Shayshez/Dazzle/README.md

# Dazzle
## CC-BY-SA 4.0
Rotatable Dual VC-Polarizer and VCA, Based on MI "Blinds".

## ROTATABLE = Modules for 3u / 1u
Dazzle comes with 2 panels: 1u/20hp and 3u/6hp
