Shayshez/Dazzle/Dazzles_v1_BOM.xlsx

Qty | Value | Device | Package | Parts | Description
1 | DNP | Resistor, 1% | R0603 | R35 | RESISTOR, American symbol
2 | 402R | Resistor, 1% | R0603 | R5, R6 | RESISTOR, American symbol
4 | 510R | Resistor, 1% | R0603 | R26, R31, R36, R43 | RESISTOR, American symbol
6 | 1.2k | Resistor, 1% | R0603 | R37, R38, R56, R57, R58, R59 | RESISTOR, American symbol
2 | 3.90k | Resistor, 0.1%, thin film | R0603 | R14, R15 | RESISTOR, American symbol
6 | 4.30k | Resistor, 0.1%, thin film | R0603 | R11, R16, R17, R18, R29, R32 | RESISTOR, American symbol
4 | 33.20k | Resistor, 0.1%, thin film | R0603 | R8, R28, R44, R50 | RESISTOR, American symbol
4 | 66.50k | Resistor, 0.1%, thin film | R0603 | R9, R12, R13, R30 | RESISTOR, American symbol
10 | 100.0k | Resistor, 0.1%, thin film | R0603 | R21, R22, R23, R24, R25, R27, R33, R34, R60, R61 | RESISTOR, American symbol
8 | 100k | Resistor, 1% | R0603 | R39, R40, R41, R42, R47, R48, R52, R55 | RESISTOR, American symbol
2 | 205.0k | Resistor, 0.1%, thin film | R0603 | R53, R54 | RESISTOR, American symbol
8 | 1.0M | Resistor, 1% | R0603 | R7, R10, R19, R20, R45, R46, R49, R51 | RESISTOR, American symbol
6 | 47p | Capacitor, ceramic, C0G >= 50V, 1% | C0603 | C13, C14, C20, C21, C22, C23 | CAPACITOR, American symbol
4 | 560p | Capacitor, ceramic, C0G | C0603 | C15, C17, C18, C19 | CAPACITOR, American symbol
15 | 100n | C-USC0603 | C0603 | C3, C4, C5, C6, C7, C8, C9, C10, C11, C12, C16, C24, C25, C26, C27 | CAPACITOR, American symbol
2 | 22u | CPOL-USC | PANASONIC_C | C1, C2 | POLARIZED CAPACITOR, American symbol
1 | PTCSMD | PTCSMD | PTC-1206 | P1 | Resettable Fuse PTC
2 | Ferrite Beads | WE-CBF_0603 | L0603 | L1, L2 | SMD EMI Suppression Ferrite Beads
2 | 1N5819HW | DIODE-SOD123 | SOD123 | D1, D2 | DIODE
2 | LM4040B10 | LM4041B12DBZ | DBZ_R-PDSO-G3 | IC6, IC7 | PRECISION MICROPOWER SHUNT VOLTAGE REFERENCE
4 | OPA4171 | TL074PW | TSSOP14 | IC1, IC2, IC4, IC5 | OP AMP
1 | V2164SZ | SSM2164S | SOIC16N | IC3
2 | WP7113SRSGW | LED5MM | LED5MM | LED3, LED4 | LED
2 | WP937EGW | LED3MM | LED3MM | LED1, LED2 | LED
1 | MIX IN/OUT | 2 * 1 2.54mm Pin Header | 2.54mm Pin Header | J1 | WR-PHD 2.54mm Pin Header, 2 Pin=>Code : Con_BTB_PHD_2.54_1_THT_61300211121
2 | 10kB | POT_USVERTICAL_PS | ALPS_POT_VERTICAL_PS | R1, R2
2 | 10kB | POT-ALPS_POT_USVERTICAL_PS | POT-ALPS_ALPS_POT_VERTICAL_PS | R3, R4
1 | POWER_SIMPLE | POWER_SIMPLE | 2X05_SMT_HEADER | POWER!
6 | OG-PJ301_PJ301_THONKICONN | OG-PJ301_PJ301_THONKICONN | OG-PJ301_WQP_PJ_301M6_NO_HOLE | CV_1, CV_2, IN_1, IN_2, OUT_1, OUT_2
