Shayshez/Dazzle/Dazzle_v1.brd

## EAGLE design Dazzle_v1.brd (2018-11-22)

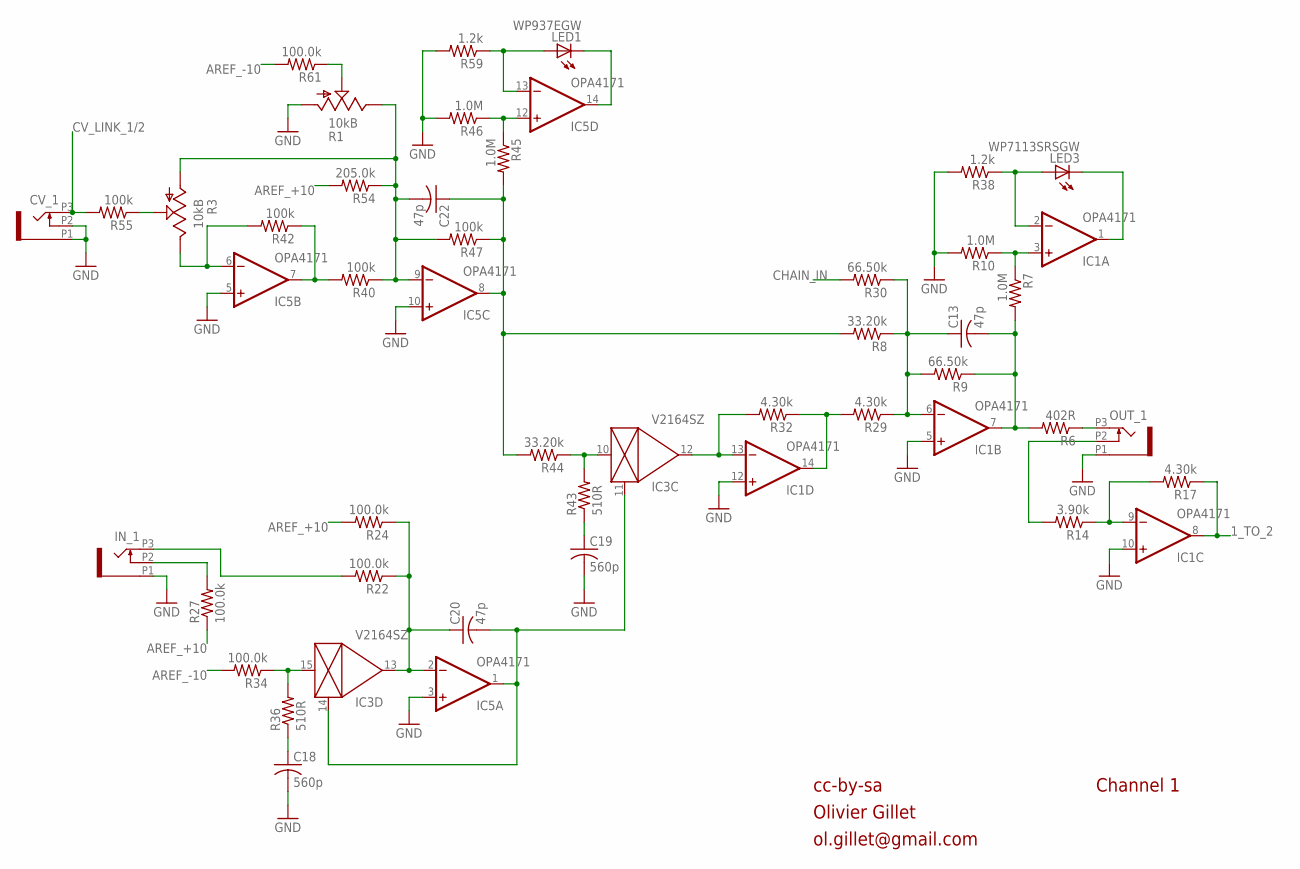
[picture p1: schematic Dazzle_v1.sch, sheet 1]

Parts:
C13, C20, C22: 47p; C0603
C18, C19: 560p; C0603
CV_1: OG-PJ301_PJ301_THONKICONN; OG-PJ301_WQP_PJ_301M6_NO_HOLE
IC1, IC5: OPA4171; TSSOP14
IC3: V2164SZ; SOIC16N
IN_1: OG-PJ301_PJ301_THONKICONN; OG-PJ301_WQP_PJ_301M6_NO_HOLE
LED1: WP937EGW; LED3MM
LED3: WP7113SRSGW; LED5MM
OUT_1: OG-PJ301_PJ301_THONKICONN; OG-PJ301_WQP_PJ_301M6_NO_HOLE
R1: 10kB; ALPS_POT_VERTICAL_PS
R3: 10kB; POT-ALPS_ALPS_POT_VERTICAL_PS
R6: 402R; R0603
R7, R10, R45, R46: 1.0M; R0603
R8, R44: 33.20k; R0603
R9, R30: 66.50k; R0603
R14: 3.90k; R0603
R17, R29, R32: 4.30k; R0603
R22, R24, R27, R34, R61: 100.0k; R0603
R36, R43: 510R; R0603
R38, R59: 1.2k; R0603
R40, R42, R47, R55: 100k; R0603
R54: 205.0k; R0603

Connections:
1_TO_2: IC1.8 (OUT), R17.1; also elsewhere on the board
AREF_+10: R24.2, R27.1, R54.2; also elsewhere on the board
AREF_-10: R34.2, R61.2; also elsewhere on the board
CHAIN_IN: R30.2; also elsewhere on the board
CV_LINK_1/2: CV_1.P3 (3), R55.2; also elsewhere on the board
FOO: IC3.15 (IN), R34.1, R36.2
GAIN_1: C22.1, IC5.8 (OUT), R8.2, R44.2, R45.2, R47.1
GND: C18.2, C19.2, CV_1.P1 (1), CV_1.P2 (2), IC1.5 (+IN), IC1.10 (+IN), IC1.12 (+IN), IC5.3 (+IN), IC5.5 (+IN), IC5.10 (+IN), IN_1.P1 (1), OUT_1.P1 (1), R1.P$3 (A), R10.2, R38.2, R46.2, R59.2; also elsewhere on the board
unnamed: R1.P$2 (S), R61.1
unnamed: IC1.13 (-IN), IC3.12 (OUT), R32.2
unnamed: IC5.14 (OUT), LED1.K (C)
unnamed: IC5.6 (-IN), R3.P$1 (E), R42.2
unnamed: OUT_1.P3 (3), R6.1
unnamed: IC5.7 (OUT), R40.2, R42.1
unnamed: C22.2, IC5.9 (-IN), R1.P$1 (E), R3.P$3 (A), R40.1, R47.2, R54.1
unnamed: C13.1, IC1.6 (-IN), R8.1, R9.2, R29.1, R30.1
unnamed: R3.P$2 (S), R55.1
unnamed: IC5.13 (-IN), LED1.A, R59.1
unnamed: IC1.1 (OUT), LED3.K (C)
unnamed: IC1.2 (-IN), LED3.A, R38.1
unnamed: C18.1, R36.1
unnamed: IN_1.P3 (3), R22.2
unnamed: IC1.9 (-IN), R14.1, R17.2
unnamed: OUT_1.P2 (2), R14.2
unnamed: C19.1, R43.1
unnamed: IN_1.P2 (2), R27.2
unnamed: IC1.14 (OUT), R29.2, R32.1
unnamed: C20.1, IC3.13 (OUT), IC5.2 (-IN), R22.1, R24.1
unnamed: C20.2, IC3.11 (CTRL), IC3.14 (CTRL), IC5.1 (OUT)
unnamed: IC3.10 (IN), R43.2, R44.1
unnamed: IC1.3 (+IN), R7.1, R10.1
unnamed: IC5.12 (+IN), R45.1, R46.1
OUT1: C13.2, IC1.7 (OUT), R6.2, R7.2, R9.1

Notes on the sheet:
cc-by-sa
Olivier Gillet
ol.gillet@gmail.com
Channel 1

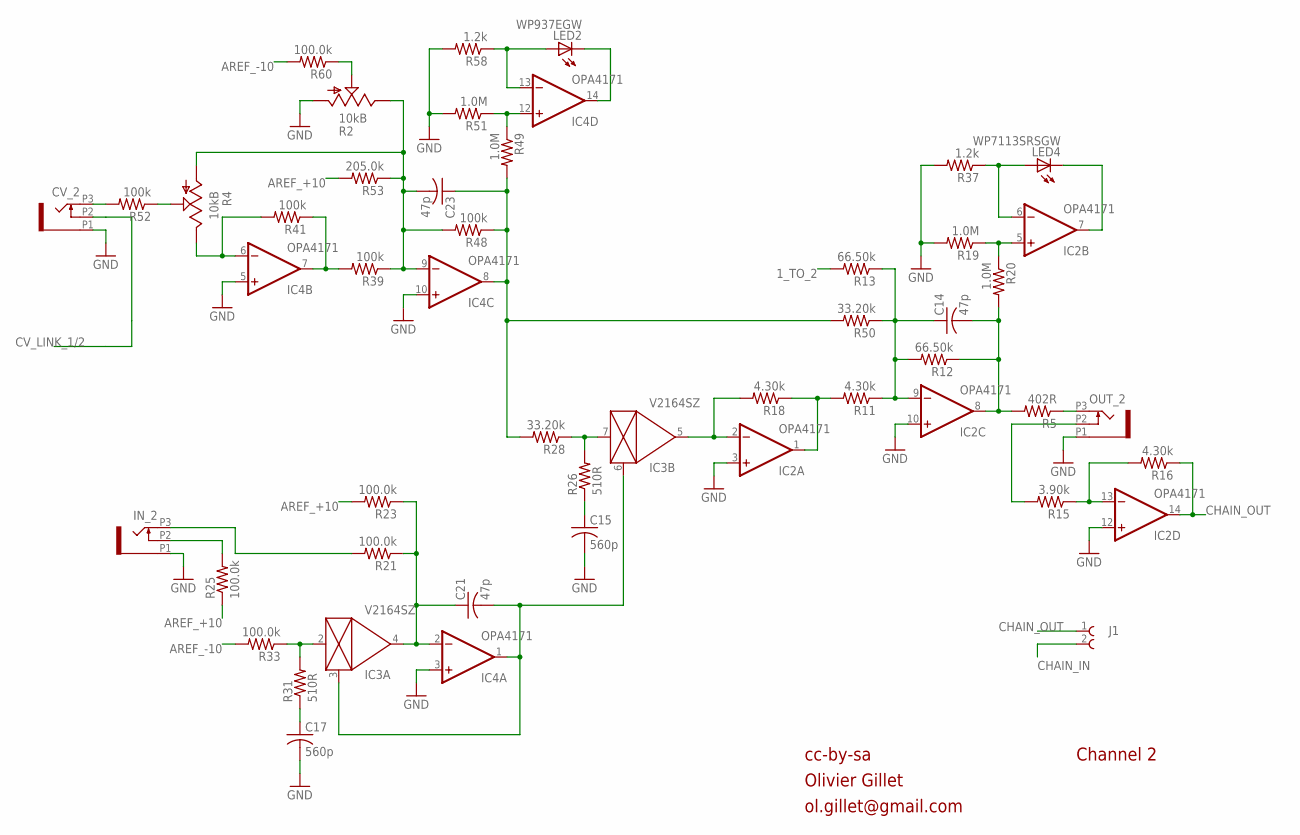
[picture p2: schematic Dazzle_v1.sch, sheet 2]

Parts:
C14, C21, C23: 47p; C0603
C15, C17: 560p; C0603
CV_2: OG-PJ301_PJ301_THONKICONN; OG-PJ301_WQP_PJ_301M6_NO_HOLE
IC2, IC4: OPA4171; TSSOP14
IC3: V2164SZ; SOIC16N
IN_2: OG-PJ301_PJ301_THONKICONN; OG-PJ301_WQP_PJ_301M6_NO_HOLE
J1: 61300211121
LED2: WP937EGW; LED3MM
LED4: WP7113SRSGW; LED5MM
OUT_2: OG-PJ301_PJ301_THONKICONN; OG-PJ301_WQP_PJ_301M6_NO_HOLE
R2: 10kB; ALPS_POT_VERTICAL_PS
R4: 10kB; POT-ALPS_ALPS_POT_VERTICAL_PS
R5: 402R; R0603
R11, R16, R18: 4.30k; R0603
R12, R13: 66.50k; R0603
R15: 3.90k; R0603
R19, R20, R49, R51: 1.0M; R0603
R21, R23, R25, R33, R60: 100.0k; R0603
R26, R31: 510R; R0603
R28, R50: 33.20k; R0603
R37, R58: 1.2k; R0603
R39, R41, R48, R52: 100k; R0603
R53: 205.0k; R0603

Connections:
1_TO_2: R13.2; also elsewhere on the board
AREF_+10: R23.2, R25.1, R53.2; also elsewhere on the board
AREF_-10: R33.2, R60.2; also elsewhere on the board
CHAIN_IN: J1.2; also elsewhere on the board
CHAIN_OUT: IC2.14 (OUT), J1.1, R16.1
CV_LINK_1/2: CV_2.P2 (2); also elsewhere on the board
FOO1: IC3.2 (IN), R31.2, R33.1
GAIN_2: C23.1, IC4.8 (OUT), R28.2, R48.1, R49.2, R50.2
GND: C15.2, C17.2, CV_2.P1 (1), IC2.3 (+IN), IC2.10 (+IN), IC2.12 (+IN), IC4.3 (+IN), IC4.5 (+IN), IC4.10 (+IN), IN_2.P1 (1), OUT_2.P1 (1), R2.P$3 (A), R19.2, R37.2, R51.2, R58.2; also elsewhere on the board
unnamed: OUT_2.P3 (3), R5.1
unnamed: C15.1, R26.1
unnamed: IC3.7 (IN), R26.2, R28.1
unnamed: IC2.2 (-IN), IC3.5 (OUT), R18.2
unnamed: C14.1, IC2.9 (-IN), R11.1, R12.2, R13.1, R50.1
unnamed: CV_2.P3 (3), R52.2
unnamed: IC4.6 (-IN), R4.P$1 (E), R41.2
unnamed: IC4.7 (OUT), R39.2, R41.1
unnamed: C23.2, IC4.9 (-IN), R2.P$1 (E), R4.P$3 (A), R39.1, R48.2, R53.1
unnamed: R2.P$2 (S), R60.1
unnamed: IC4.14 (OUT), LED2.K (C)
unnamed: IC4.13 (-IN), LED2.A, R58.1
unnamed: IC2.7 (OUT), LED4.K (C)
unnamed: IC2.6 (-IN), LED4.A, R37.1
unnamed: IC2.13 (-IN), R15.1, R16.2
unnamed: OUT_2.P2 (2), R15.2
unnamed: IC2.1 (OUT), R11.2, R18.1
unnamed: R4.P$2 (S), R52.1
unnamed: C17.1, R31.1
unnamed: C21.1, IC3.4 (OUT), IC4.2 (-IN), R21.1, R23.1
unnamed: C21.2, IC3.3 (CTRL), IC3.6 (CTRL), IC4.1 (OUT)
unnamed: IN_2.P3 (3), R21.2
unnamed: IN_2.P2 (2), R25.2
unnamed: IC2.5 (+IN), R19.1, R20.1
unnamed: IC4.12 (+IN), R49.1, R51.1
OUT2: C14.2, IC2.8 (OUT), R5.2, R12.1, R20.2

Notes on the sheet:
cc-by-sa
Olivier Gillet
ol.gillet@gmail.com
Channel 2

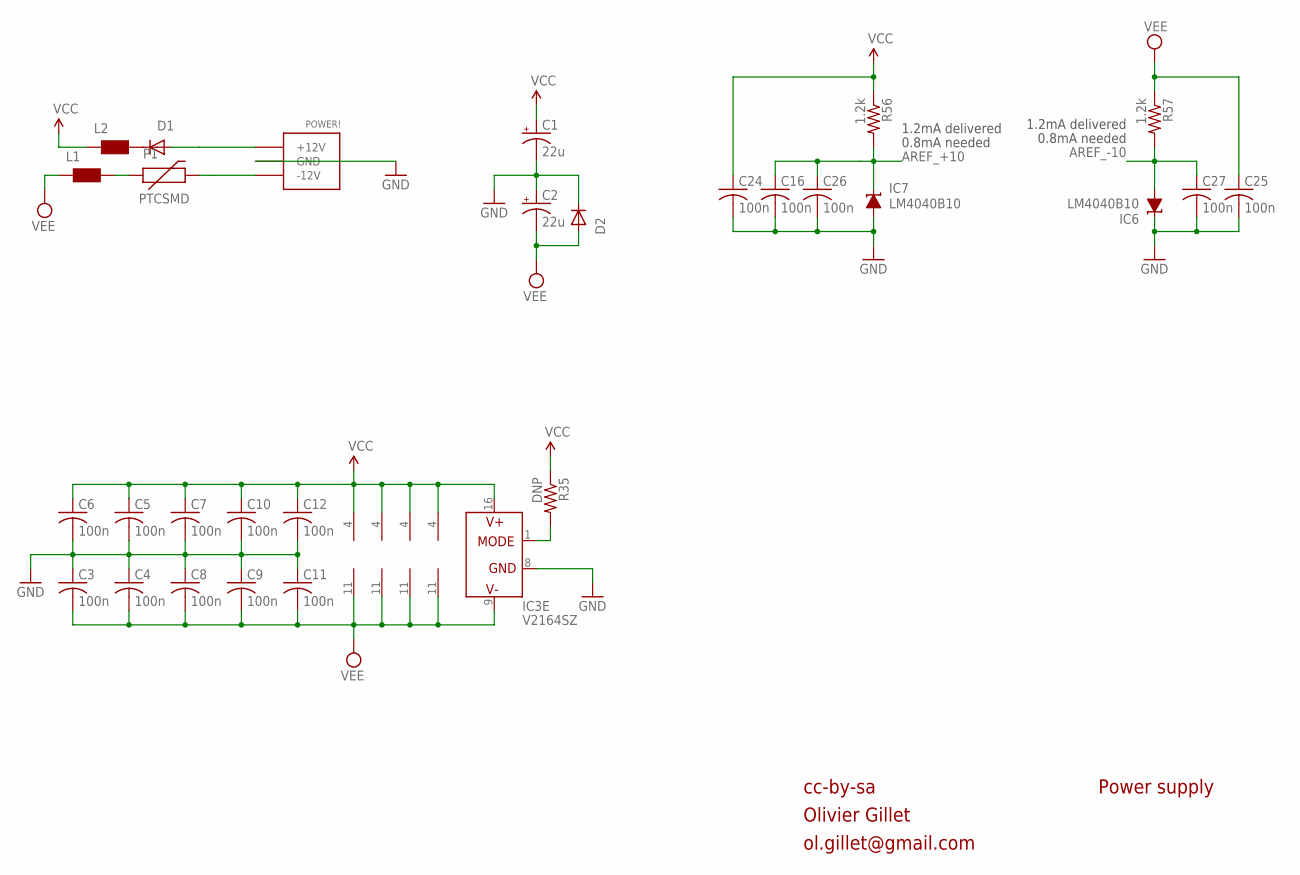
[picture p3: schematic Dazzle_v1.sch, sheet 3]

Parts:
C1, C2: 22u; PANASONIC_C
C3, C4, C5, C6, C7, C8, C9, C10, C11, C12, C16, C24, C25, C26, C27: 100n; C0603
D1, D2: 1N5819HW; SOD123
IC1, IC2, IC4, IC5: OPA4171; TSSOP14
IC3: V2164SZ; SOIC16N
IC6, IC7: LM4040B10; DBZ_R-PDSO-G3
L1, L2: WE-CBF_0603; 0603
P1: PTCSMD; PTC-1206
POWER!: POWER_SIMPLE; 2X05_SMT_HEADER
R35: DNP; R0603
R56, R57: 1.2k; R0603

Connections:
AREF_+10: C16.1, C26.1, IC7.1 (C), R56.2; also elsewhere on the board
AREF_-10: C27.1, IC6.2 (A), R57.2; also elsewhere on the board
GND: C1.-, C2.+, C3.1, C4.1, C5.2, C6.2, C7.2, C8.1, C9.1, C10.2, C11.1, C12.2, C16.2, C24.2, C25.2, C26.2, C27.2, D2.C, IC3.8 (GND), IC6.1 (C), IC7.2 (A), POWER!.3 (GND), POWER!.4 (GND), POWER!.5 (GND), POWER!.6 (GND), POWER!.7 (GND), POWER!.8 (GND); also elsewhere on the board
unnamed: IC3.1 (MODE), R35.2
unnamed: D1.A, POWER!.9 (+12V), POWER!.10 (+12V)
unnamed: P1.2, POWER!.1 (-12V), POWER!.2 (-12V)
unnamed: L1.2, P1.1
unnamed: D1.C, L2.2
VCC: C1.+, C5.1, C6.1, C7.1, C10.1, C12.1, C24.1, IC1.4 (V+), IC2.4 (V+), IC3.16 (V+), IC4.4 (V+), IC5.4 (V+), L2.1, R35.1, R56.1
VEE: C2.-, C3.2, C4.2, C8.2, C9.2, C11.2, C25.1, D2.A, IC1.11 (V-), IC2.11 (V-), IC3.9 (V-), IC4.11 (V-), IC5.11 (V-), L1.1, R57.1

Notes on the sheet:
cc-by-sa
Olivier Gillet
ol.gillet@gmail.com
Power supply
1.2mA delivered
0.8mA needed

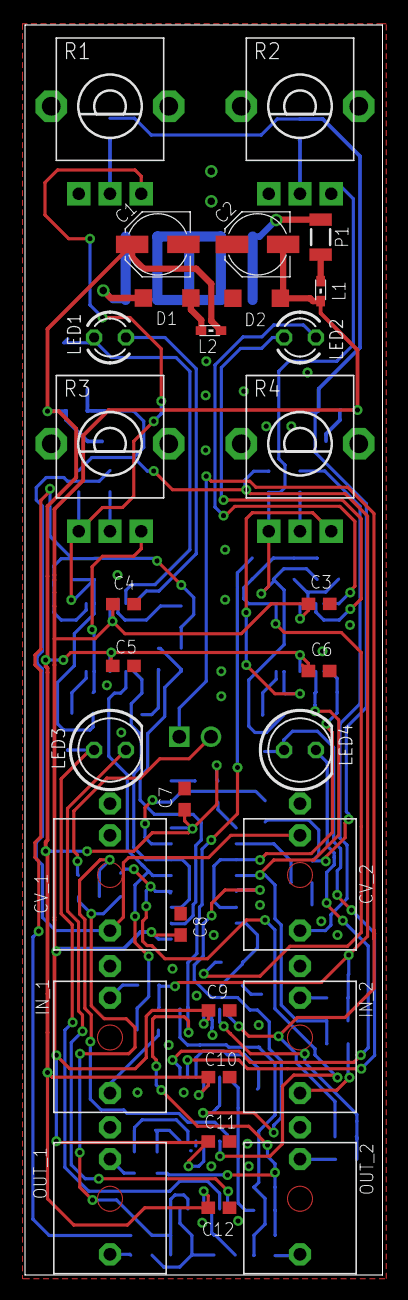
[picture p4: board Dazzle_v1.brd from above]

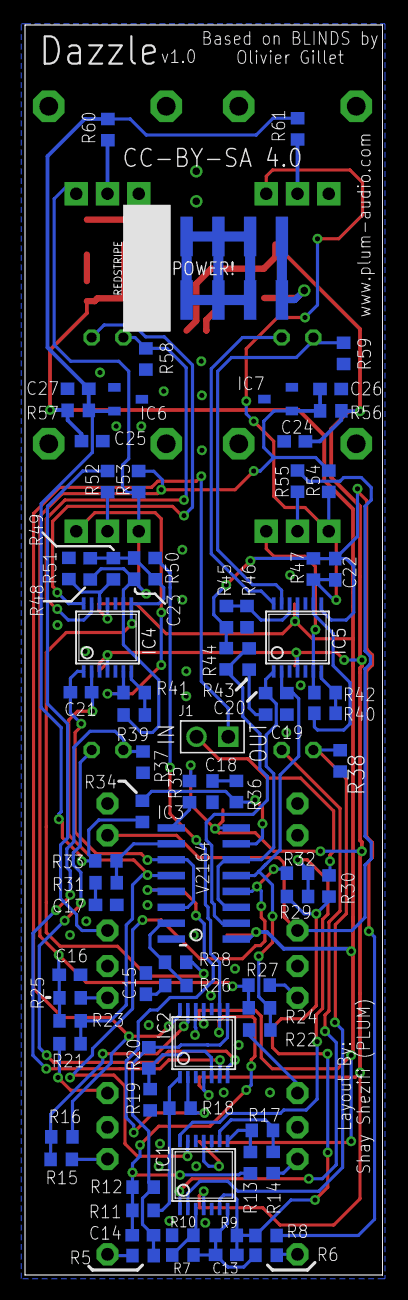
[picture p5: board Dazzle_v1.brd from below]

Board: 2 copper layers, 28.6 x 100.0 mm, 112 parts (81 on the bottom side), 69 nets.
